mrkct/console/hardware/console.kicad_pcb

## KiCad design hardware/console.kicad_pcb (2026-08-13)

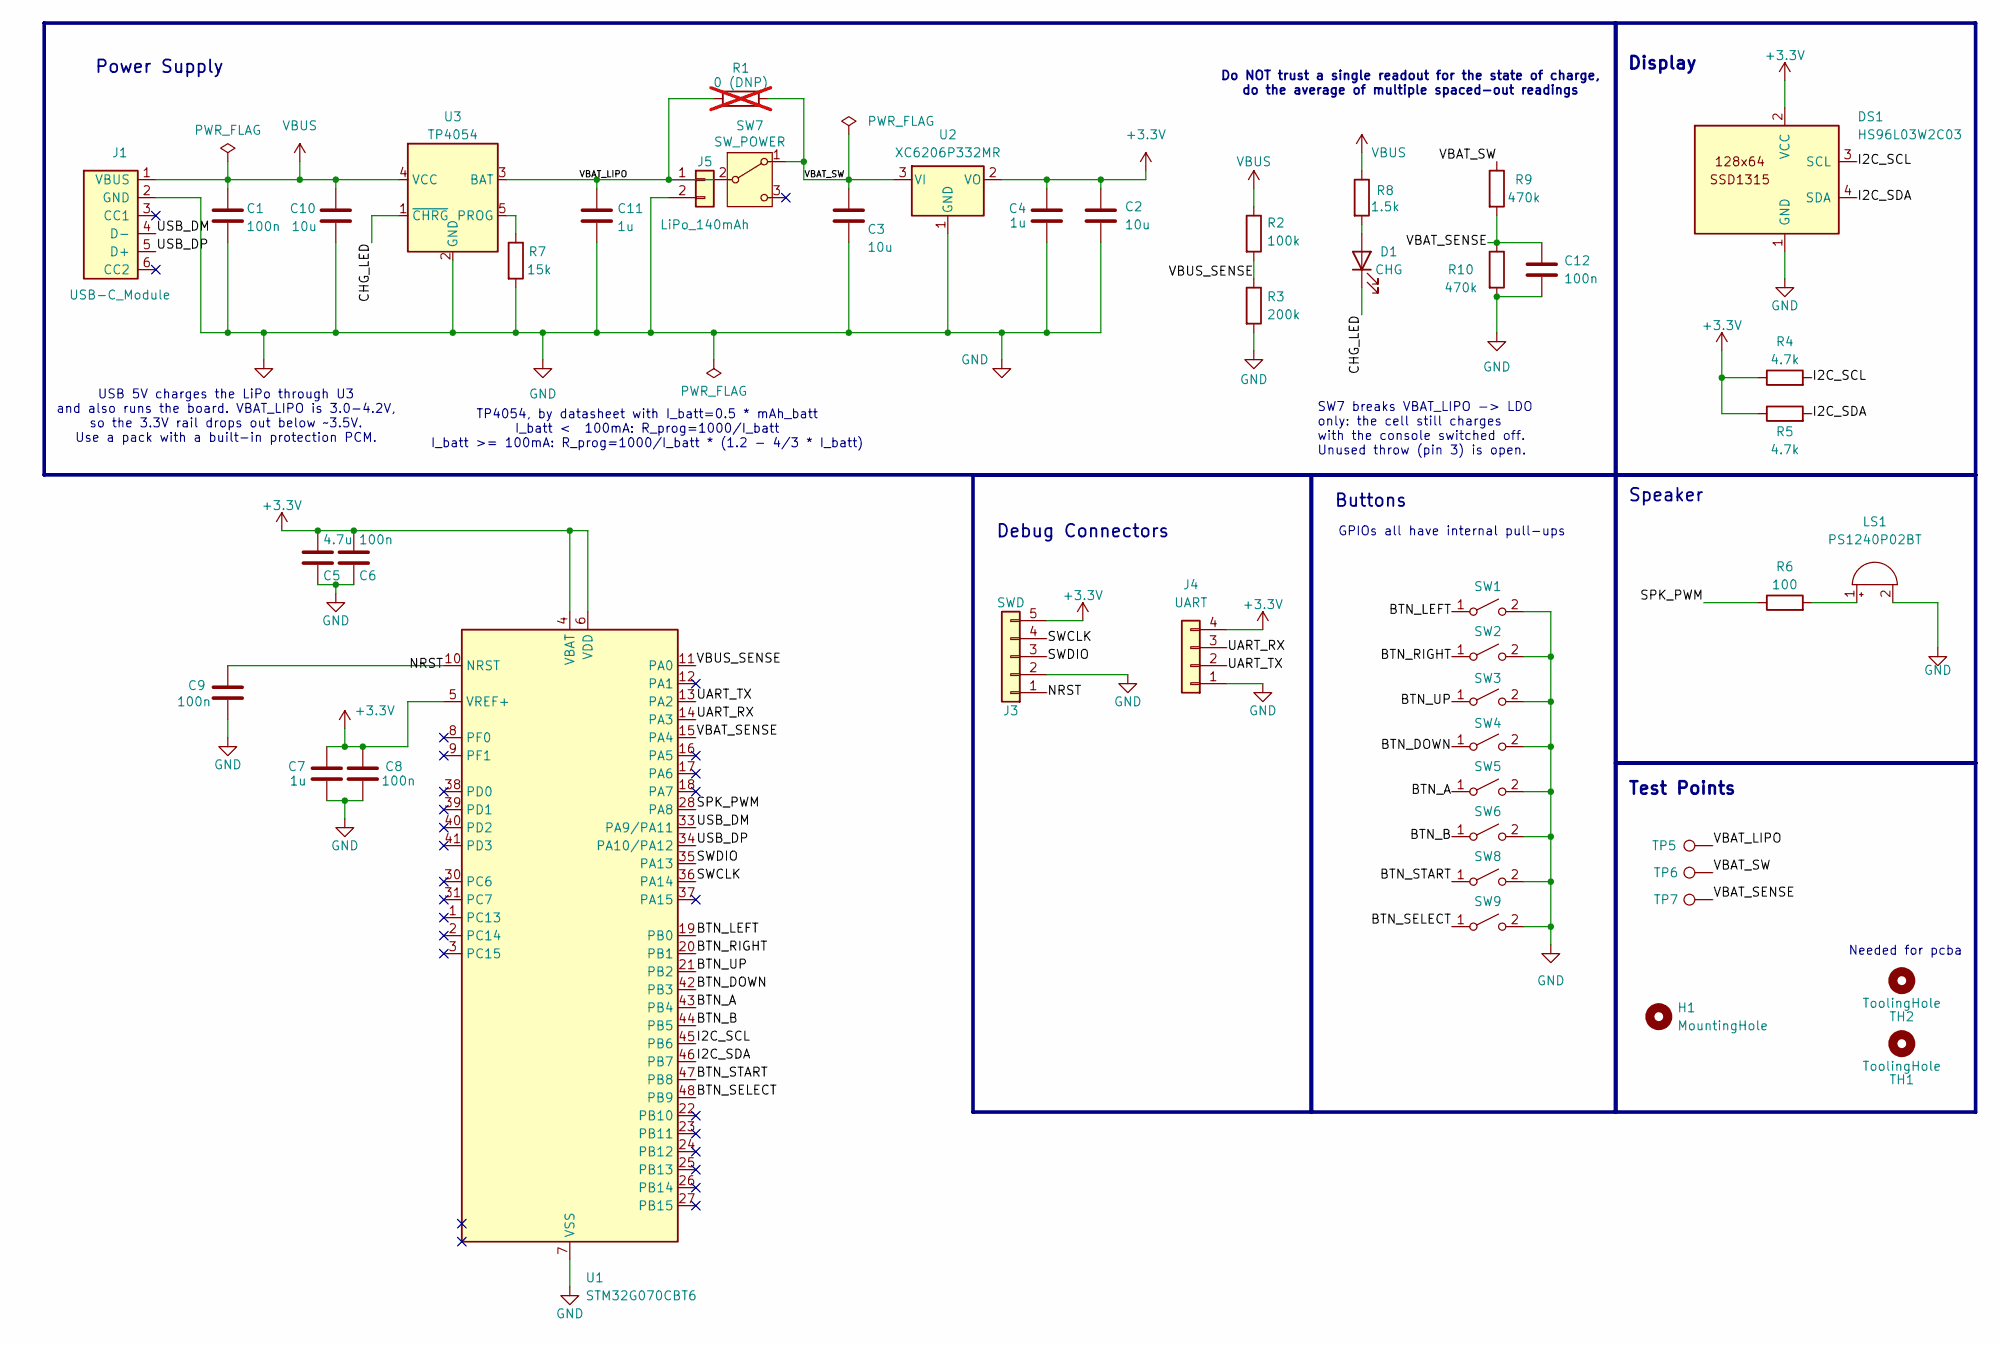
[picture p1: schematic console.kicad_sch, MicroConsole]

Parts:
C1, C6, C8, C9, C12: 100n; C_0402_1005Metric; Voltage 16V; MPN CL05B104KO5NNNC; LCSC C1525
C2, C3, C10: 10u; C_0805_2012Metric; Voltage 25V; MPN CL21A106KAYNNNE; LCSC C15850
C4, C7, C11: 1u; C_0402_1005Metric; Voltage 25V; MPN CL05A105KA5NQNC; LCSC C52923
C5: 4.7u; C_0603_1608Metric; Voltage 16V; MPN CL10A475KO8NNNC; LCSC C19666
D1: CHG; LED_0603_1608Metric; MPN KT-0603R; LCSC C2286
DS1: HS96L03W2C03; OLED-TH_L27.8-W27.2-P2.54_C9900033791; LCSC C5248080
H1: MountingHole; MountingHole_2.1mm
J1: USB-C_Module; USBC-TH_L21.6-W12.8-P2.54
J3: SWD; PinHeader_1x05_P2.54mm_Vertical
J4: UART; PinHeader_1x04_P2.54mm_Vertical
J5: LiPo_140mAh; JST_PH_S2B-PH-K_1x02_P2.00mm_Horizontal; MPN BX-PH2.0-2PZZ; LCSC C18077744
LS1: PS1240P02BT; Buzzer_TDK_PS1240P02BT_D12.2mm_H6.5mm; MPN PS1240P02BT; LCSC C76871
R1: 0 (DNP); R_0402_1005Metric; not fitted
R2: 100k; R_0402_1005Metric; Tolerance 1%; MPN 0402WGF1003TCE; LCSC C25741
R3: 200k; R_0402_1005Metric; Tolerance 1%; MPN 0402WGF2003TCE; LCSC C25764
R4, R5: 4.7k; R_0402_1005Metric; Tolerance 1%; MPN 0402WGF4701TCE; LCSC C25900
R6: 100; R_0402_1005Metric; Tolerance 1%; MPN 0402WGF1000TCE; LCSC C25076
R7: 15k; R_0402_1005Metric; Tolerance 1%; MPN 0402WGF1502TCE; LCSC C25756
R8: 1.5k; R_0402_1005Metric; Tolerance 1%; MPN 0402WGF1501TCE; LCSC C25867
R9, R10: 470k; R_0603_1608Metric; Tolerance 1%; MPN 0603WAF4703T5E; LCSC C23178
SW1, SW2, SW3, SW4, SW5, SW6, SW8, SW9: SW_PUSH; SW_SPST_TS-1088-xR020; LCSC C720477
SW7: SW_POWER; SW-TH_L8.5-W3.5-P2.50-D0.9; MPN SS-12D00
TH1, TH2: ToolingHole; TOOL-NPTH-D1.152
TP5: VBAT_LIPO; TestPoint_THTPad_D1.5mm_Drill0.7mm
TP6: VBAT_SW; TestPoint_THTPad_D1.5mm_Drill0.7mm
TP7: VBAT_SENSE; TestPoint_THTPad_D1.5mm_Drill0.7mm
U1: STM32G070CBT6; LQFP-48_7x7mm_P0.5mm; MPN STM32G070CBT6; LCSC C529338
U2: XC6206P332MR; SOT-23-3; MPN XC6206P332MR-G; LCSC C5446
U3: TP4054; SOT-23-5; MPN TP4054-42-SOT25R; LCSC C32574

Connections:
+3.3V: C2.1, C4.1, C5.1, C6.1, C7.1, C8.1, DS1.2 (VCC), J3.5, J4.4, R4.1, R5.1, U1.4 (VBAT), U1.5 (VREF+), U1.6 (VDD), U2.2 (VO)
/BTN_A: SW5.1 (A), U1.43 (PB4)
/BTN_B: SW6.1 (A), U1.44 (PB5)
/BTN_DOWN: SW4.1 (A), U1.42 (PB3)
/BTN_LEFT: SW1.1 (A), U1.19 (PB0)
/BTN_RIGHT: SW2.1 (A), U1.20 (PB1)
/BTN_SELECT: SW9.1 (A), U1.48 (PB9)
/BTN_START: SW8.1 (A), U1.47 (PB8)
/BTN_UP: SW3.1 (A), U1.21 (PB2)
/CHG_LED: D1.1 (K), U3.1 (~CHRG)
/I2C_SCL: DS1.3 (SCL), R4.2, U1.45 (PB6)
/I2C_SDA: DS1.4 (SDA), R5.2, U1.46 (PB7)
/NRST: C9.1, J3.1, U1.10 (NRST)
/SPK_PWM: R6.1, U1.28 (PA8)
/SWCLK: J3.4, U1.36 (PA14)
/SWDIO: J3.3, U1.35 (PA13)
/UART_RX: J4.3, U1.14 (PA3)
/UART_TX: J4.2, U1.13 (PA2)
/USB_DM: J1.4 (D-), U1.33 (PA9/PA11)
/USB_DP: J1.5 (D+), U1.34 (PA10/PA12)
/VBAT_LIPO: C11.1, J5.1, R1.1, SW7.2 (B), TP5.1 (1_1), U3.3 (BAT)
/VBAT_SENSE: C12.1, R9.2, R10.1, TP7.1 (1_1), U1.15 (PA4)
/VBAT_SW: C3.1, R1.2, R9.1, SW7.1 (A), TP6.1 (1_1), U2.3 (VI)
/VBUS_SENSE: R2.2, R3.1, U1.11 (PA0)
GND: C1.2, C2.2, C3.2, C4.2, C5.2, C6.2, C7.2, C8.2, C9.2, C10.2, C11.2, C12.2, DS1.1 (GND), J1.2 (GND), J3.2, J4.1, J5.2, LS1.2 (-), R3.2, R7.2, R10.2, SW1.2 (B), SW2.2 (B), SW3.2 (B), SW4.2 (B), SW5.2 (B), SW6.2 (B), SW8.2 (B), SW9.2 (B), U1.7 (VSS), U2.1 (GND), U3.2 (GND)
unnamed: D1.2 (A), R8.2
unnamed: LS1.1 (+), R6.2
unnamed: R7.1, U3.5 (PROG)
VBUS: C1.1, C10.1, J1.1 (VBUS), R2.1, R8.1, U3.4 (VCC)

Notes on the sheet:
GPIOs all have internal pull-ups
Do NOT trust a single readout for the state of charge, do the average of multiple spaced-out readings
TP4054, by datasheet with I_batt=0.5 * mAh_batt I_batt < 100mA: R_prog=1000/I_batt I_batt >= 100mA: R_prog=1000/I_batt * (1.2 - 4/3 * I_batt)
USB 5V charges the LiPo through U3 and also runs the board. VBAT_LIPO is 3.0-4.2V, so the 3.3V rail drops out below ~3.5V. Use a pack with a built-in protection PCM.
Debug Connectors
Needed for pcba
Power Supply
Buttons
Test Points
Speaker
SW7 breaks VBAT_LIPO -> LDO only: the cell still charges with the console switched off. Unused throw (pin 3) is open.
Display

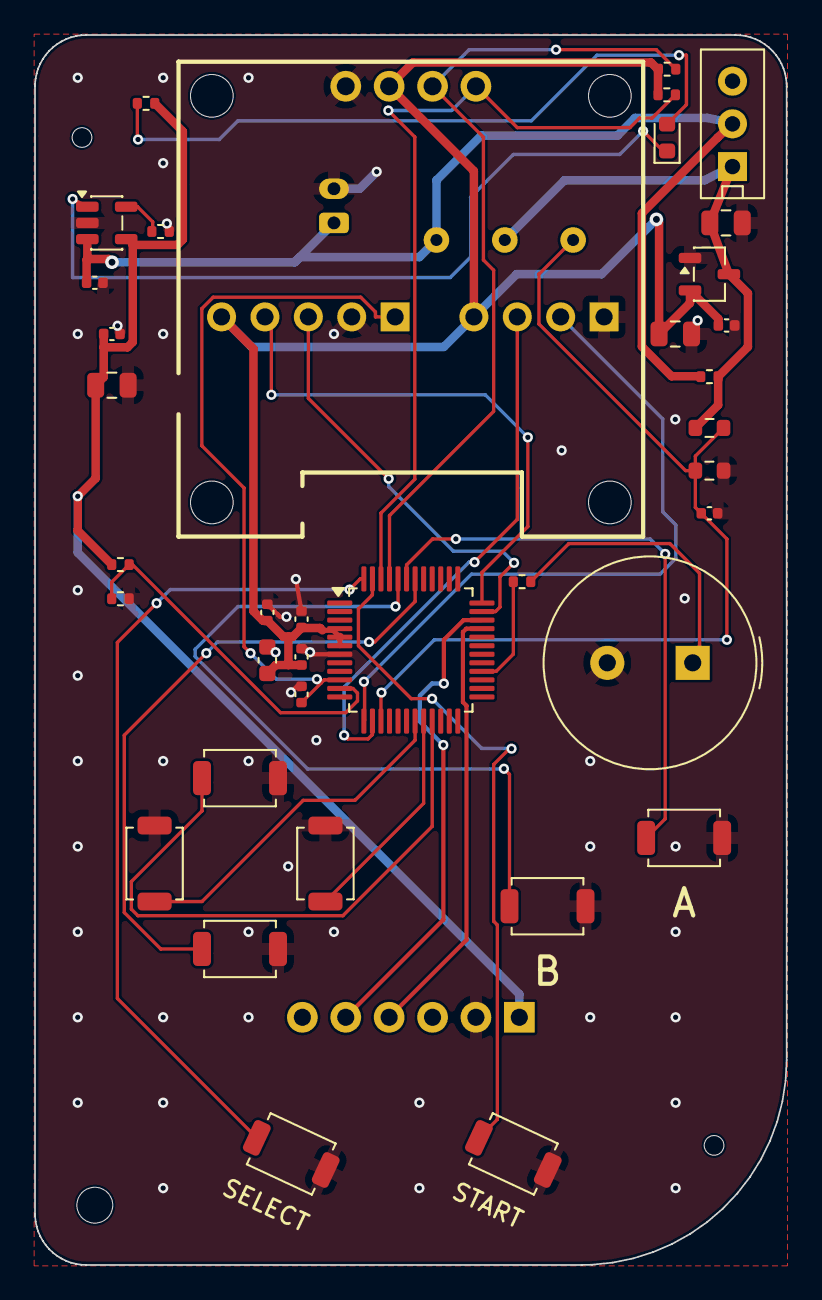
[picture p2: board console.kicad_pcb from above]

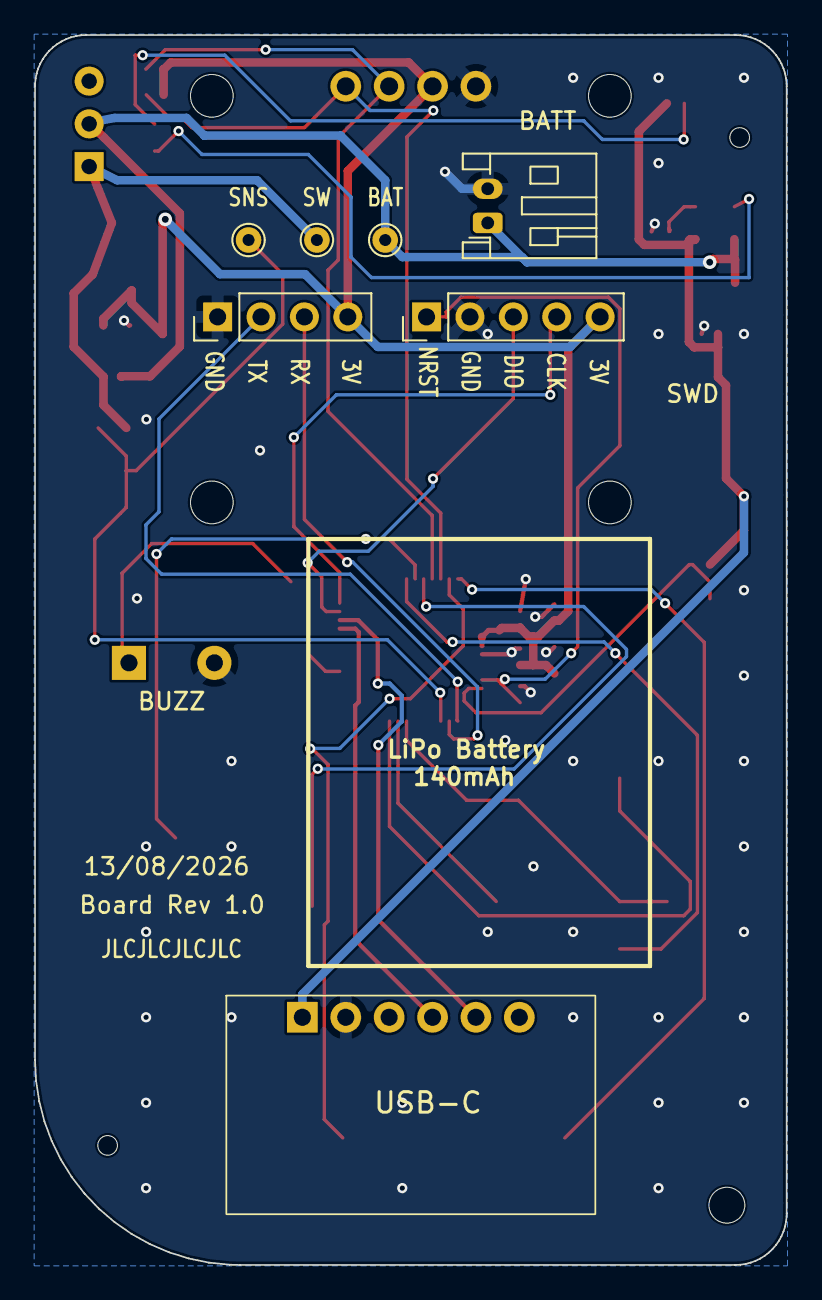
[picture p3: board console.kicad_pcb from below]

Board: 2 copper layers, 44.0 x 72.0 mm, 47 parts (7 on the bottom side), 29 nets.
