mrkct/console/firmware/firmware.ioc

Mcu.UserName=STM32G0B1CBTx
PA0.Signal=SYS_WKUP1
PA13.Signal=SYS_SWDIO
PA14-BOOT0.Signal=SYS_SWCLK
PA2.GPIO_Label=UART_TX
PA2.Signal=USART2_TX
PA3.GPIO_Label=UART_RX
PA3.Signal=USART2_RX
PA4.GPIO_Label=VBAT_SENSE
PA4.Signal=ADC1_IN4
PA8.GPIO_Label=SPK_PWM
PA8.Signal=S_TIM1_CH1
PB0.GPIO_Label=BTN_LEFT
PB0.Signal=GPIO_Input
PB1.GPIO_Label=BTN_RIGHT
PB1.Signal=GPIO_Input
PB2.GPIO_Label=BTN_UP
PB2.Signal=GPIO_Input
PB3.GPIO_Label=BTN_DOWN
PB3.Signal=GPIO_Input
PB4.GPIO_Label=BTN_A
PB4.Signal=GPIO_Input
PB5.GPIO_Label=BTN_B
PB5.Signal=GPIO_Input
PB6.Signal=I2C1_SCL
PB7.Signal=I2C1_SDA
PB8.GPIO_Label=BTN_START
PB8.Signal=GPIO_Input
PB9.GPIO_Label=BTN_SELECT
PB9.Signal=GPIO_Input
