mrkct/console/(commit log)

2026-08-01 first draft of power supply
    [console.kicad_pcb, console.kicad_sch]
2026-08-02 everything with old power supply
    [console.kicad_sch]
2026-08-02 move stuff around
    [console.kicad_sch]
2026-08-07 START and SELECT btns
    [console.kicad_pcb, console.kicad_sch]
2026-08-07 change mcu
    [console.kicad_sch]
2026-08-07 resistor and caps footprints
    [console.kicad_sch]
2026-08-07 validated pinout + stm32cubemx .ioc
    [console.kicad_sch]
2026-08-08 remove the boot0 btn
    [console.kicad_pcb, console.kicad_sch]
2026-08-08 footprint for usb module, and a AI-generated 3d model
    [console.kicad_pcb, console.kicad_sch]
2026-08-08 clean pcb
    [console.kicad_pcb]
2026-08-09 first claude-made pcb design
    [console.kicad_pcb]
2026-08-09 fix 3d model offset and assembly fuckups by claude
    [console.kicad_pcb, console.kicad_sch]
2026-08-09 change some components to be manually soldered
    [console.kicad_pcb, console.kicad_sch]
2026-08-09 manufacturing checkboxes
    [console.kicad_pcb]
2026-08-10 change the mcu ... again
    [console.kicad_pcb, console.kicad_sch]
2026-08-10 pushbutton values
    [console.kicad_pcb, console.kicad_sch]
2026-08-11 move switch and chrg led to the top right
    [console.kicad_pcb, console.kicad_sch]
2026-08-11 more silkscreen
    [console.kicad_pcb]
2026-08-11 fix battery connector
    [console.kicad_pcb, console.kicad_sch]
2026-08-12 change buzzer
    [console.kicad_pcb, console.kicad_sch]
2026-08-13 BOM/POS flags
    [console.kicad_pcb, console.kicad_sch]
2026-08-13 hardware is done, this is what was sent
    [BOM-console.csv, console.kicad_pcb, console.kicad_sch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]
